vonsivers/Thermochromic-Clock-Frame/BoM.ods

Sheet: Segment PCB
Qty | Description | Item No | Distributor | Link | Price/Pc (EUR)
28 | Stiftleiste, SMD, gerade, 1x2-polig - PH | JST PH2P STS | Reichelt | https://www.reichelt.de/jst-stiftleiste-smd-gerade-1x2-polig-ph-jst-ph2p-sts-p185063.html?PROVID=2788 | 0,26
56 | Platinenabstandshalter, M3x5mm Kunststoff, Schraubbolzen + Mutter | - | ebay.de | https://www.ebay.de/itm/284104629243?ssPageName=STRK%3AMEBIDX%3AIT&var=585596381017 | 0,35
28 | JST PH 2.0 Stecker / Buchse 26AWG Kabel 30cm, 2-Pin | - | ebay.de | https://www.ebay.de/itm/183607216953?ssPageName=STRK%3AMEBIDX%3AIT&var=691029636494 | 0,91
1 | Liquid Crystal Thermochromic Colour Changing Sheet, 300x450mm, 30-35°C | - | SFXC | https://www.sfxc.co.uk/products/lc-liquid-crystal-thermochromic-sheets?variant=6780065857 | 40

Sheet: Controller PCB
Qty | Description | Item No | Distributor | Link | Price/Pc (EUR)
1 | DS18B20 Temperatursensor | - | ebay.de | https://www.ebay.de/itm/154748673919 | 5,49
4 | SN74HC595 Shift Register | 74HC 595 | reichelt.de | https://www.reichelt.de/shift-register-3-state-ausgang-2--6-v-dil-16-74hc-595-p3269.html?trstct=pos_0&nbc=1 | 0,31
1 | Lötbare Schraubklemme - 2-pol, RM 5 mm, 90° | CTB0502-2 | reichelt.de | https://www.reichelt.de/loetbare-schraubklemme-2-pol-rm-5-mm-90--ctb0502-2-p292691.html?trstct=pos_0&nbc=1 | 0,25
28 | SMD Widerstand 0805, 180 Ohm | - | - | - | -
32 | SMD Widerstand 0805, 10 kOhm | - | - | - | -
1 | SMD Widerstand 0805, 4.7 kOhm | - | - | - | -
4 | Ceramic Capacitor 0805, 0.1µF | - | - | - | -
1 | Wemos D1 Mini, ESP8266 | - | ebay.de | https://www.ebay.de/itm/165105633523?ssPageName=STRK%3AMEBIDX%3AIT&var=464659265107 | 3,67
4 | Male Pin Header 2x7, RM 2.54mm, vertical | - | - | - | -
14 | TSM9926DCS MOSFET 2 x N-Kanal, 20 V, 6 A | TSM9926DCS | reichelt.de | https://www.reichelt.de/mosfet-2-x-n-kanal-20-v-6-a-rds-on-0-021-ohm-so-8-tsm9926dcs-p254992.html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 | 0,52
1 | DC Cable, 2.1x5.5mm, female to bare wire | 1715115 – 62 | conrad.de | https://www.conrad.de/de/p/tru-components-tc-2511304-niedervolt-anschlusskabel-niedervolt-buchse-offene-kabelenden-5-50-mm-2-10-mm-1-00-m-1-st-1715115.html | 4,49
1 | 5V, 5A power supply | - | - | - | -

Sheet: Frame
Qty | Description | Item No | Distributor | Link | Price/Pc (EUR)
1 | Zuschnitt Profil 20 - silber matt - 28 x 35 cm Bildmaß | AZ20AN- 0280x0350 | alutech.de | - | 22,39
1 | Forex® 3 mm Hartschaumplatte - weiß - 28 x 35 cm | ZBFX3xx- 0280x0350 | alutech.de | - | 3,46
1 | Poly-Pack Nr.2 Montageset | ZBPN2-1 | alutech.de | - | 2,13
2 | Schraub-Aufhänger | ZBSC-1 | alutech.de | - | 0,35
1 | Black Anodized Aluminium Plate 280x350x2mm (see dxf) | - | Schaeffer AG | - | 94,32
