vonsivers/Thermochromic-Clock-Frame/dxf/tcc_frontplate_v21.dxf

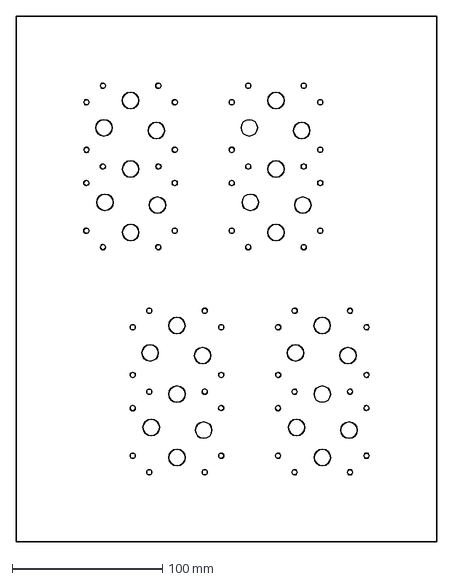
[picture p1: CAD file, 2022-01-02]
dxf/tcc_frontplate_v21.dxf
280.0 x 350.0 mm
