vonsivers/Thermochromic-Clock-Frame/PCBs/thermochromic clock segments/seg2.dxf

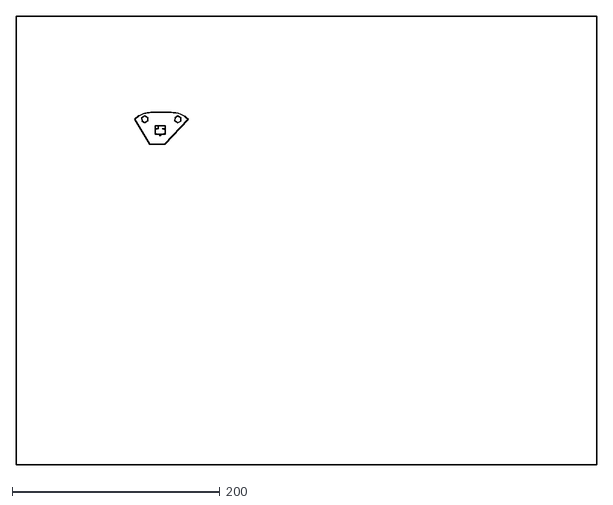
[picture p2: CAD file, 2022-01-02]
PCBs/thermochromic clock segments/seg2.dxf
558.8 x 431.8
