vonsivers/Thermochromic-Clock-Frame/PCBs/thermochromic clock segments/seg1-Edge_Cuts.dxf

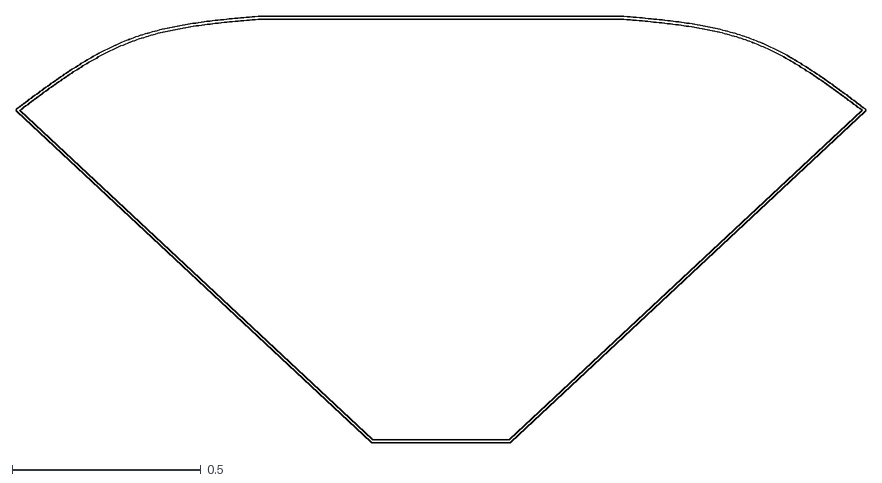
[picture p3: CAD file, 2022-01-02]
PCBs/thermochromic clock segments/seg1-Edge_Cuts.dxf
2.25 x 1.13
