vonsivers/Thermochromic-Clock-Frame/PCBs/thermochromic clock segments/seg1.dxf

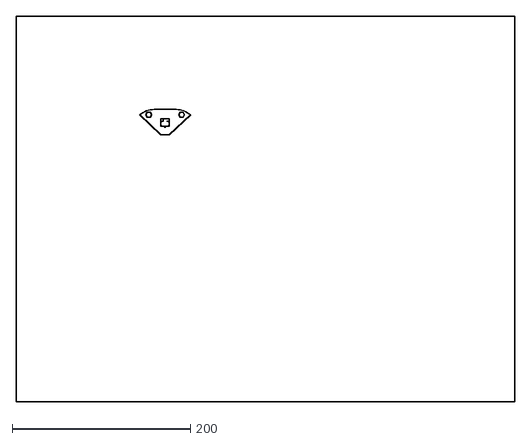
[picture p4: CAD file, 2022-01-02]
PCBs/thermochromic clock segments/seg1.dxf
558.8 x 431.8
