vonsivers/Thermochromic-Clock-Frame/PCBs/thermochromic clock segments/seg1-B_CrtYd.dxf

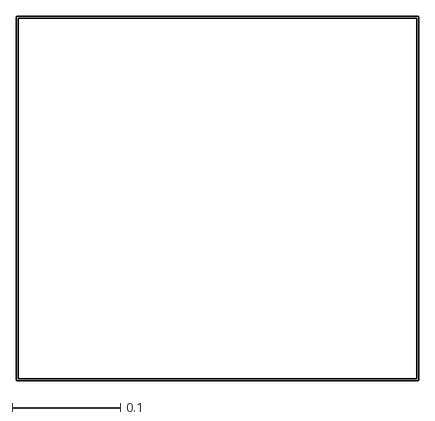
[picture p5: CAD file, 2022-01-02]
PCBs/thermochromic clock segments/seg1-B_CrtYd.dxf
0.372 x 0.337
