vonsivers/Thermochromic-Clock-Frame/PCBs/thermochromic clock segments/seg3.dxf

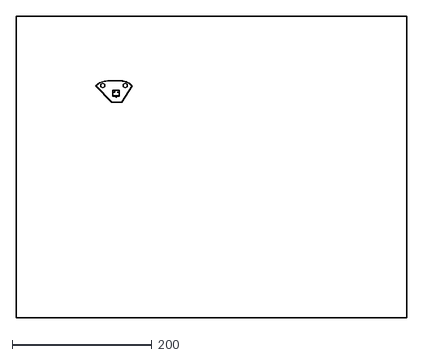
[picture p6: CAD file, 2022-01-02]
PCBs/thermochromic clock segments/seg3.dxf
558.8 x 431.8
