vonsivers/Thermochromic-Clock-Frame/PCBs/thermochromic clock segments/seg4.step

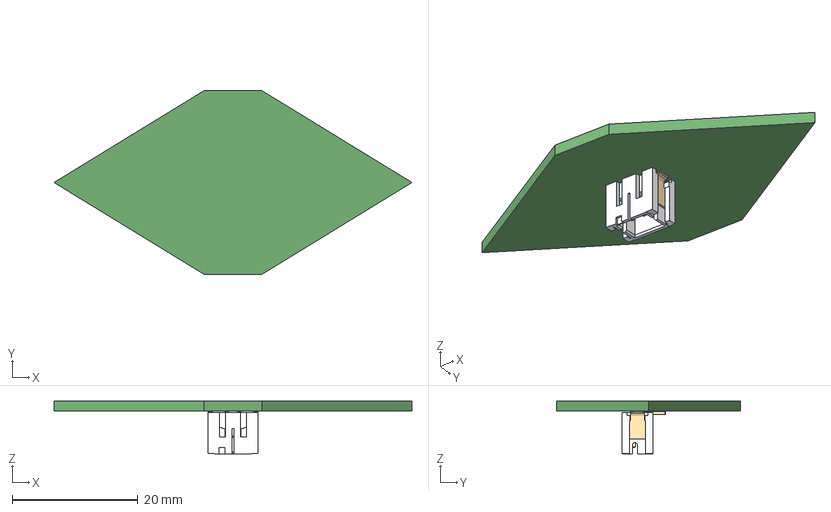
[picture p7: CAD file, 2022-01-02]
PCBs/thermochromic clock segments/seg4.step
57.0 x 29.2 x 8.38 mm
