vonsivers/Thermochromic-Clock-Frame/(list of files, cad)

Other CAD files:
PCBs/thermochromic clock segments/seg1-B_SilkS.dxf
PCBs/thermochromic clock segments/seg4.dxf
