vonsivers/Thermochromic-Clock-Frame/PCBs/thermochromic clock controller/thermochromic clock controller.kicad_pcb

## KiCad design PCBs/thermochromic clock controller/thermochromic clock controller.kicad_pcb (2022-01-02)

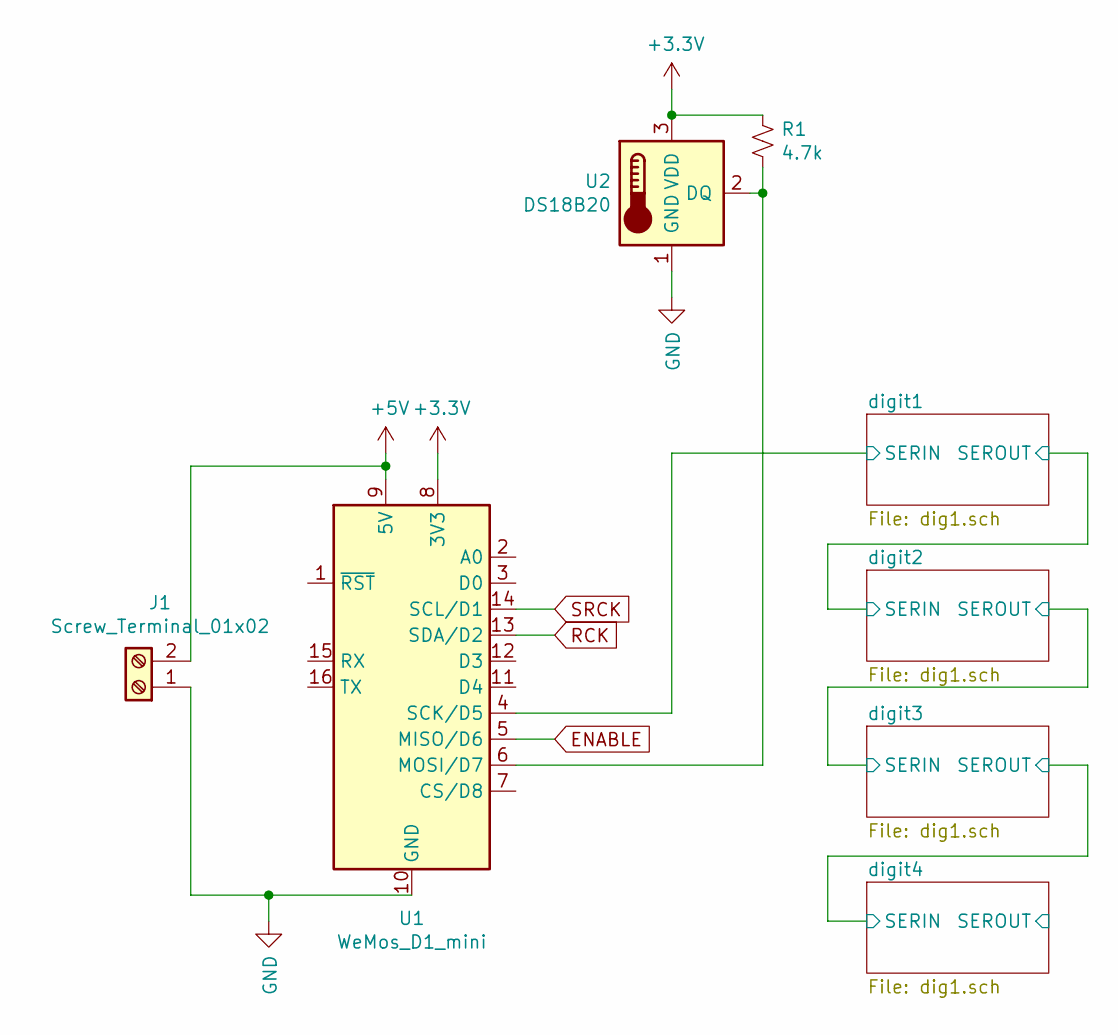
[picture p8: schematic thermochromic clock controller.sch]

Parts:
J1: Screw_Terminal_01x02; TerminalBlock_MetzConnect_Type011_RT05502HBWC_1x02_P5.00mm_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
R1: 4.7k; R_0805_2012Metric_Pad1.15x1.40mm_HandSolder
U1: WeMos_D1_mini; WEMOS_D1_mini_light
U2: DS18B20; TO-92_Inline

Connections:
+3V3: R1.1, U1.8 (3V3), U2.3 (VDD); also elsewhere on the board
+5V: J1.2, U1.9 (5V); also elsewhere on the board
/digit1/SERIN: U1.4 (SCK/D5); also elsewhere on the board
ENABLE: U1.5 (MISO/D6); also elsewhere on the board
GND: J1.1, U1.10 (GND), U2.1 (GND); also elsewhere on the board
unnamed: R1.2, U1.6 (MOSI/D7), U2.2 (DQ)
RCK: U1.13 (SDA/D2); also elsewhere on the board
SRCK: U1.14 (SCL/D1); also elsewhere on the board

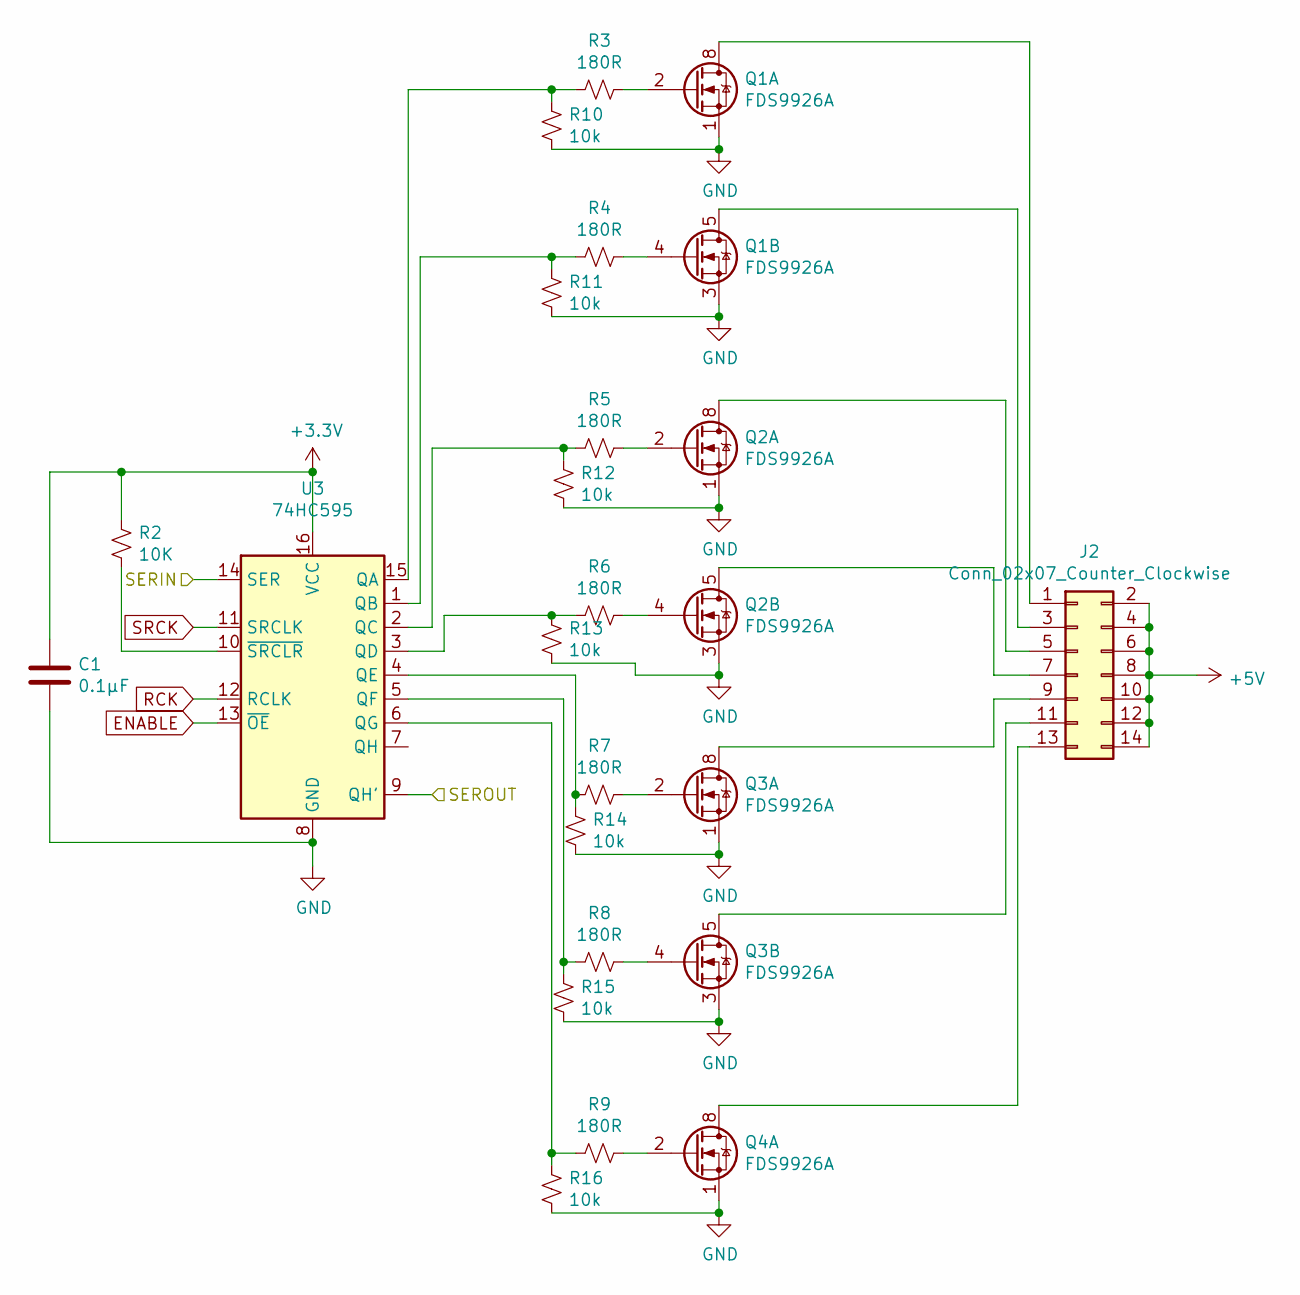
[picture p9: schematic dig1.sch]

Parts:
C1: 0.1µF; C_0805_2012Metric_Pad1.15x1.40mm_HandSolder
J2: Conn_02x07_Counter_Clockwise; PinHeader_2x07_P2.54mm_Vertical
Q1, Q2, Q3, Q4: FDS9926A; SOIC-8_3.9x4.9mm_P1.27mm
R2: 10K; R_0805_2012Metric_Pad1.15x1.40mm_HandSolder
R3, R4, R5, R6, R7, R8, R9: 180R; R_0805_2012Metric_Pad1.15x1.40mm_HandSolder
R10, R11, R12, R13, R14, R15, R16: 10k; R_0805_2012Metric_Pad1.15x1.40mm_HandSolder
U3: 74HC595; DIP-16_W7.62mm

Connections:
+3V3: C1.1, R2.2, U3.16 (VCC); also elsewhere on the board
+5V: J2.2, J2.4, J2.6, J2.8, J2.10, J2.12, J2.14; also elsewhere on the board
/digit1/SERIN: U3.14 (SER); also elsewhere on the board
/digit2/SERIN: U3.9 (QH'); also elsewhere on the board
ENABLE: U3.13 (~OE); also elsewhere on the board
GND: C1.2, Q1.1 (S1), Q1.3 (S2), Q2.1 (S1), Q2.3 (S2), Q3.1 (S1), Q3.3 (S2), Q4.1 (S1), Q4.3 (S2), R10.1, R11.1, R12.1, R13.1, R14.1, R15.1, R16.1, U3.8 (GND); also elsewhere on the board
unnamed: J2.1, Q1.7 (D1), Q1.8 (D1)
unnamed: J2.3, Q1.5 (D2), Q1.6 (D2)
unnamed: J2.5, Q2.7 (D1), Q2.8 (D1)
unnamed: J2.7, Q2.5 (D2), Q2.6 (D2)
unnamed: J2.9, Q3.7 (D1), Q3.8 (D1)
unnamed: J2.11, Q3.5 (D2), Q3.6 (D2)
unnamed: J2.13, Q4.7 (D1), Q4.8 (D1)
unnamed 16: Q4.5 (D2), Q4.6 (D2); also elsewhere on the board
unnamed: Q1.2 (G1), R3.1
unnamed: Q1.4 (G2), R4.1
unnamed: Q2.2 (G1), R5.1
unnamed: Q2.4 (G2), R6.1
unnamed: Q3.2 (G1), R7.1
unnamed: Q3.4 (G2), R8.1
unnamed: Q4.2 (G1), R9.1
unnamed 44: Q4.4 (G2); also elsewhere on the board
unnamed: R2.1, U3.10 (~SRCLR)
unnamed: R3.2, R10.2, U3.15 (QA)
unnamed: R4.2, R11.2, U3.1 (QB)
unnamed: R5.2, R12.2, U3.2 (QC)
unnamed: R6.2, R13.2, U3.3 (QD)
unnamed: R7.2, R14.2, U3.4 (QE)
unnamed: R8.2, R15.2, U3.5 (QF)
unnamed: R9.2, R16.2, U3.6 (QG)
RCK: U3.12 (RCLK); also elsewhere on the board
SRCK: U3.11 (SRCLK); also elsewhere on the board

Parts of its further copies:
C2, C3, C4: 0.1µF; C_0805_2012Metric_Pad1.15x1.40mm_HandSolder
J3, J4, J5: Conn_02x07_Counter_Clockwise; PinHeader_2x07_P2.54mm_Vertical
Q5, Q6, Q7, Q8, Q9, Q10, Q11, Q12, Q13, Q14: FDS9926A; SOIC-8_3.9x4.9mm_P1.27mm
R17, R32, R47: 10K; R_0805_2012Metric_Pad1.15x1.40mm_HandSolder
R18, R19, R20, R21, R22, R23, R24, R33, R34, R35, R36, R37, R38, R39, R48, R49, R50, R51, R52, R53, R54: 180R; R_0805_2012Metric_Pad1.15x1.40mm_HandSolder
R25, R26, R27, R28, R29, R30, R31, R40, R41, R42, R43, R44, R45, R46, R55, R56, R57, R58, R59, R60, R61: 10k; R_0805_2012Metric_Pad1.15x1.40mm_HandSolder
U4, U5, U6: 74HC595; DIP-16_W7.62mm

Connections of its further copies:
+3V3: C2.1, C3.1, C4.1, R17.2, R32.2, R47.2, U4.16 (VCC), U5.16 (VCC), U6.16 (VCC); also elsewhere on the board
+5V: J3.2, J3.4, J3.6, J3.8, J3.10, J3.12, J3.14, J4.2, J4.4, J4.6, J4.8, J4.10, J4.12, J4.14, J5.2, J5.4, J5.6, J5.8, J5.10, J5.12, J5.14; also elsewhere on the board
/digit2/SERIN: U4.14 (SER); also elsewhere on the board
/digit3/SERIN: U4.9 (QH'), U5.14 (SER)
/digit4/SERIN: U5.9 (QH'), U6.14 (SER)
/digit4/SEROUT: U6.9 (QH')
ENABLE: U4.13 (~OE), U5.13 (~OE), U6.13 (~OE); also elsewhere on the board
GND: C2.2, C3.2, C4.2, Q5.1 (S1), Q5.3 (S2), Q6.1 (S1), Q6.3 (S2), Q7.1 (S1), Q7.3 (S2), Q8.1 (S1), Q8.3 (S2), Q9.1 (S1), Q9.3 (S2), Q10.1 (S1), Q10.3 (S2), Q11.1 (S1), Q11.3 (S2), Q12.1 (S1), Q12.3 (S2), Q13.1 (S1), Q13.3 (S2), Q14.1 (S1), Q14.3 (S2), R25.1, R26.1, R27.1, R28.1, R29.1, R30.1, R31.1, R40.1, R41.1, R42.1, R43.1, R44.1, R45.1, R46.1, R55.1, R56.1, R57.1, R58.1, R59.1, R60.1, R61.1, U4.8 (GND), U5.8 (GND), U6.8 (GND); also elsewhere on the board
unnamed 16: J3.1; also elsewhere on the board
unnamed: J3.3, Q5.7 (D1), Q5.8 (D1)
unnamed: J3.5, Q5.5 (D2), Q5.6 (D2)
unnamed: J3.7, Q6.7 (D1), Q6.8 (D1)
unnamed: J3.9, Q6.5 (D2), Q6.6 (D2)
unnamed: J3.11, Q7.7 (D1), Q7.8 (D1)
unnamed: J3.13, Q7.5 (D2), Q7.6 (D2)
unnamed: J4.1, Q8.7 (D1), Q8.8 (D1)
unnamed: J4.3, Q8.5 (D2), Q8.6 (D2)
unnamed: J4.5, Q9.7 (D1), Q9.8 (D1)
unnamed: J4.7, Q9.5 (D2), Q9.6 (D2)
unnamed: J4.9, Q10.7 (D1), Q10.8 (D1)
unnamed: J4.11, Q10.5 (D2), Q10.6 (D2)
unnamed: J4.13, Q11.7 (D1), Q11.8 (D1)
unnamed: J5.1, Q11.5 (D2), Q11.6 (D2)
unnamed: J5.3, Q12.7 (D1), Q12.8 (D1)
unnamed: J5.5, Q12.5 (D2), Q12.6 (D2)
unnamed: J5.7, Q13.7 (D1), Q13.8 (D1)
unnamed: J5.9, Q13.5 (D2), Q13.6 (D2)
unnamed: J5.11, Q14.7 (D1), Q14.8 (D1)
unnamed: J5.13, Q14.5 (D2), Q14.6 (D2)
unnamed 44: R18.1; also elsewhere on the board
unnamed: Q5.2 (G1), R19.1
unnamed: Q5.4 (G2), R20.1
unnamed: Q6.2 (G1), R21.1
unnamed: Q6.4 (G2), R22.1
unnamed: Q7.2 (G1), R23.1
unnamed: Q7.4 (G2), R24.1
unnamed: Q8.2 (G1), R33.1
unnamed: Q8.4 (G2), R34.1
unnamed: Q9.2 (G1), R35.1
unnamed: Q9.4 (G2), R36.1
unnamed: Q10.2 (G1), R37.1
unnamed: Q10.4 (G2), R38.1
unnamed: Q11.2 (G1), R39.1
unnamed: Q11.4 (G2), R48.1
unnamed: Q12.2 (G1), R49.1
unnamed: Q12.4 (G2), R50.1
unnamed: Q13.2 (G1), R51.1
unnamed: Q13.4 (G2), R52.1
unnamed: Q14.2 (G1), R53.1
unnamed: Q14.4 (G2), R54.1
unnamed: R17.1, U4.10 (~SRCLR)
unnamed: R18.2, R25.2, U4.15 (QA)
unnamed: R19.2, R26.2, U4.1 (QB)
unnamed: R20.2, R27.2, U4.2 (QC)
unnamed: R21.2, R28.2, U4.3 (QD)
unnamed: R22.2, R29.2, U4.4 (QE)
unnamed: R23.2, R30.2, U4.5 (QF)
unnamed: R24.2, R31.2, U4.6 (QG)
unnamed: R32.1, U5.10 (~SRCLR)
unnamed: R33.2, R40.2, U5.15 (QA)
unnamed: R34.2, R41.2, U5.1 (QB)
unnamed: R35.2, R42.2, U5.2 (QC)
unnamed: R36.2, R43.2, U5.3 (QD)
unnamed: R37.2, R44.2, U5.4 (QE)
unnamed: R38.2, R45.2, U5.5 (QF)
unnamed: R39.2, R46.2, U5.6 (QG)
unnamed: R47.1, U6.10 (~SRCLR)
unnamed: R48.2, R55.2, U6.15 (QA)
unnamed: R49.2, R56.2, U6.1 (QB)
unnamed: R50.2, R57.2, U6.2 (QC)
unnamed: R51.2, R58.2, U6.3 (QD)
unnamed: R52.2, R59.2, U6.4 (QE)
unnamed: R53.2, R60.2, U6.5 (QF)
unnamed: R54.2, R61.2, U6.6 (QG)
RCK: U4.12 (RCLK), U5.12 (RCLK), U6.12 (RCLK); also elsewhere on the board
SRCK: U4.11 (SRCLK), U5.11 (SRCLK), U6.11 (SRCLK); also elsewhere on the board

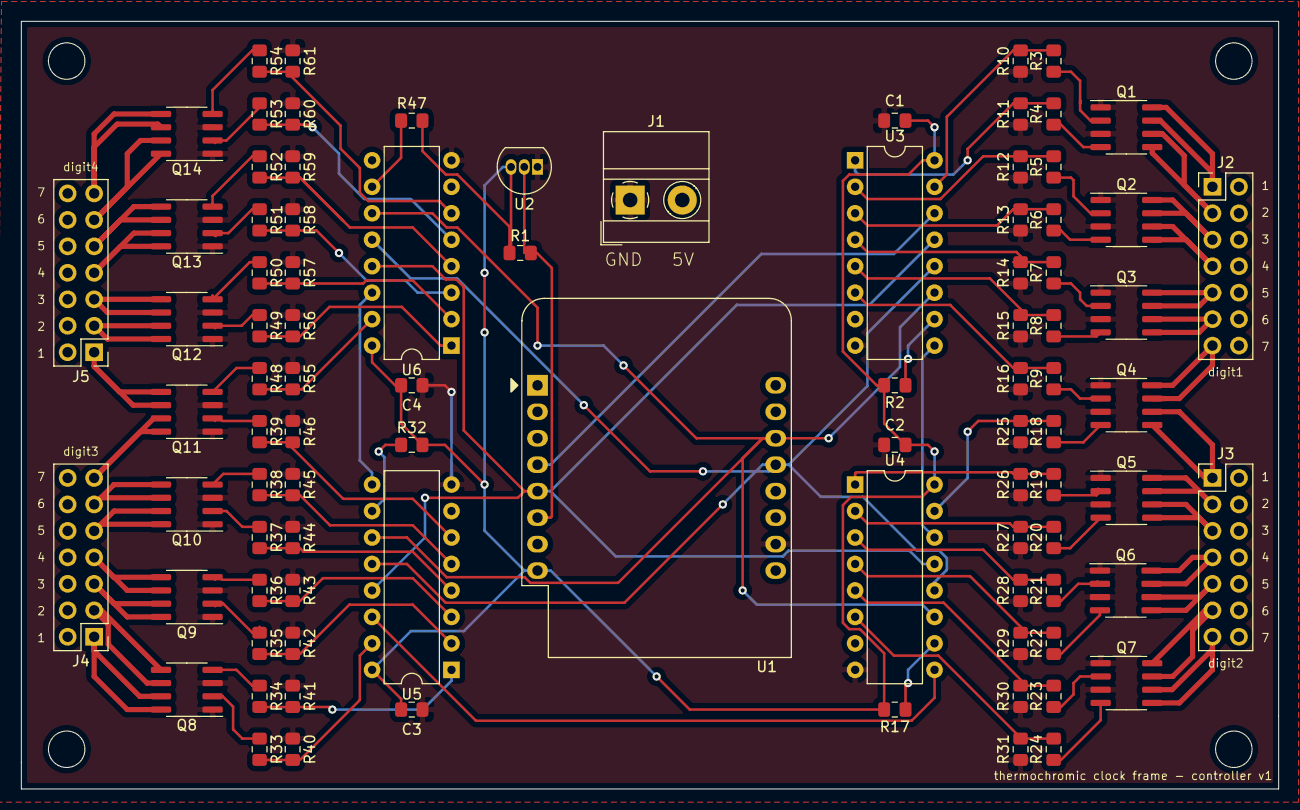
[picture p10: board thermochromic clock controller.kicad_pcb from above]

Board: 2 copper layers, 120.6 x 73.7 mm, 90 parts (0 on the bottom side), 99 nets.
